rayaanatif/qidi-q2-pen-plotter/hardware/README.md

# Hardware

All files are in `stl/` (print-ready) and `step/` (for editing). Version 4.

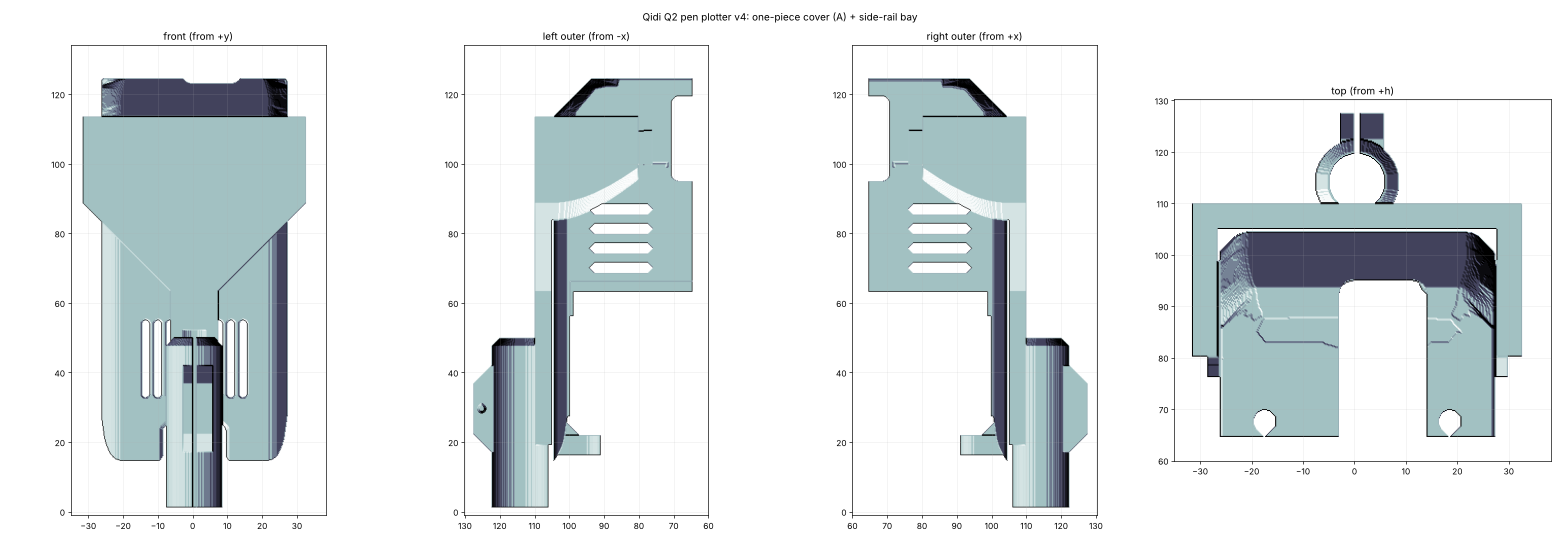
[picture p1: hardware/assembly_views.png]
assembly


| File | Print | Notes |
| --- | --- | --- |
| `qs_cover_v4_A_FRONT_DOWN_print.stl` | Cover, variant A | Front face down, no supports |
| `qs_cover_v4_B_FRONT_DOWN_print.stl` | Cover, variant B | Front face down, no supports |
| `qs_cover_v5_A_dovetail_looser_2.20_top-1.8_blockstop_gap0.15/0.40_FRONT_DOWN_print.stl` | Cover with block stop | The looser-dovetail A cover plus a 9 mm wide rib on the left lug, against the inside of the front wall, rising through the open window to a 2 mm thick hook tongue (6.4 mm deep) that sits just under the black block above the PCB. If cutting force lifts the cover, the tongue meets the block, so the cover rises only the gap (0.15 mm, or 0.40 mm if the tight one won't seat). **The tongue top is at 45.85 / 45.6 mm above the cover's bottom edge, assuming the block underside is 46.0 mm up (30 mm above the duct magnets). Measure yours with calipers before printing.** The rib is 1.4 mm thick in a ~2 mm gap in front of the PCB, so check clearance on first fit. STEP files (`..._blockstop_..._model_orientation.step`) are in `step/`. |
| `qs_pen_bay_v4_print.stl` | Pen bay | Already flipped, flat crossbar on the bed |
| `qs_pen_cartridge_v4_bore7.0.stl` to `bore11.5.stl` | Pen cartridge | Print upright. One file per pen size, in 0.5 mm steps from 7.0 to 11.5 mm. Pick the bore about 0.1 to 0.2 mm bigger than your pen's barrel. All of them have the same outside, so they fit the same bay, clip and jig. Walls get thin above 10.5 mm, so print those slowly at 100% infill |
| `qs_pen_height_jig_v1_tip3.2/4.2/5.2.stl` | Pen height jig | Sets how far the pen tip sticks out below the cartridge collar, so you don't need `PEN_TOUCH` after every pen change. Pick the number that matches your tip height (4.2 mm is what I use) |
| `qs_bay_wedge_clip_v1_end7.7/7.9/8.1.stl` | Screwless clamp | A wedge clip that slides onto the bay's two clamp ears and squeezes them shut instead of the M2 screw. See below |
| `qs_cutter_sleeve_v1_bore10.5/11.0/11.5.stl` | Cutter sleeve | Experimental, see [../docs/CUTTER.md](../docs/CUTTER.md) |

Print one cover, variant A or B (TODO: describe the difference between them).

STEP files: the cover, in print orientation and in model orientation.

## You will also need

- M2x8 screw, one (bay clamp). M2x6, M2x8 and M2x20 are the only sizes I used.
- 4 magnets, 5 x 2 mm.
- CA glue.

## Assembly

1. Fit the cover on the toolhead. For the magnets: stick each 5 x 2 mm magnet onto the duct-wing magnet (right polarity), lower the cover over them, then drip CA glue into the slot.
2. Slide the bay onto the two side rails from the **front**, toward the back, until the crossbar touches the cover face. The fit is tapered, so it is snug at the end.
3. Drop the cartridge with the pen in from the top and nip the M2x8 clamp screw.

The bay bore is 12.8 mm and the cartridge outside diameter is 12.6 mm, with a slit so the clamp screw can squeeze it onto the pen.

## Pen height jig

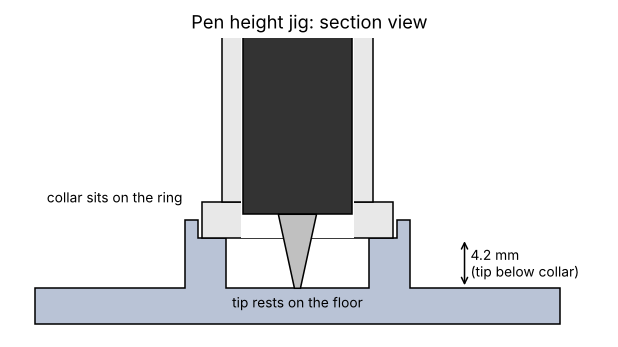
[picture p2: hardware/jig_section.png]
jig


1. Put the jig on a flat table, ring side up.
2. With the bay screw loose, stand the bay and cartridge on the jig so the cartridge collar sits on the ring.
3. Drop the pen in from the top until the tip rests on the floor.
4. Tighten the M2x8 clamp screw. The tip now sticks out exactly the same amount every time.

The three files differ only in how far the tip sticks out below the collar: 3.2, 4.2 or 5.2 mm. Use the same one every time, and keep the `z_draw` you found with it.

## Screwless wedge clip

The 7.9 version has been tested on a real Q2 and holds the cartridge well. The 7.7 and 8.1 versions are untested spares for printers that run a little tight or loose.

The bay's clamp ears are 8.8 mm thick with the slit open and 8.0 mm with it closed. The clip is a U with a tapered inside: it is 9.1 mm wide at the mouth, narrowing to 7.7, 7.9 or 8.1 mm (the number in the file name) at the bridge.

1. Set the cartridge height with the jig and leave the M2 screw out.
2. Slide the clip onto the ears from the top, bridge end first, with the thumb tab facing out, and push it until it stops.
3. The taper squeezes the slit shut. The slope is shallow enough (about 6 degrees on each side) that friction keeps it locked.

Print it upright (the U standing on its mouth) in PETG or ABS, 100% infill, 4 perimeters. Try the 7.9 first. If it will not go on, use 8.1. If it goes on but is loose, use 7.7.

## Looser dovetail cover (shorter top)

The original cover A has a very snug dovetail: it slides on but is hard to remove. These STEP files thin the cover's dovetail rails and lower the roof by 1.8 mm. The pen bay is unchanged. The roof pin holes have a flat-tipped teardrop so the roof edge stays closed above them (0.6 mm wall).

- `qs_cover_v4_A_dovetail_looser_2.20_top-1.8_FRONT_DOWN_print.step`: slightly looser (rails about 0.1 mm thinner on each flank). Try this first.
- `qs_cover_v4_A_dovetail_looser_2.10_top-1.8_FRONT_DOWN_print.step`: looser again (about 0.2 mm).
- `_model_orientation` copies of both are in the same folder.

Printed front-down, nothing overhangs more than 45.3 degrees and there are no flat downward faces above the bed.

## Stiffer, support-free pen bay (v6)

The v4 bay flexes along the short length of spine between the bracket and the pen tube. v6 adds two side wings along that section, outside the pen and collar footprint, so it still slides on and off the same way. The dovetail grooves are unchanged from v4 (0.22 mm clearance); the extra slide clearance comes from the thinner rails on the looser cover above.

The top end of the pen barrel is now a single 45 degree ramp merged into the spine instead of a floating ring, so the bay prints bracket-down with no supports. The barrel's top no longer has a flat rim, so the pen cartridge has to seat from the bottom end.

- `qs_pen_bay_v6_ramp_flanges_comb_print.step`: side wings plus three small tines that slide into the middle front vents of the cover to lock the bay sideways. Cut the tines off if they bind.
- `qs_pen_bay_v6_ramp_flanges_print.step`: side wings only.
- `_model_orientation` copies of both are in the same folder.

Printed bracket-down, nothing overhangs more than 45 degrees (the M2 teardrop holes point their tip up). The round parts (tube and bore) are 72-sided polygons in the STEP.

## Pen cartridges as STEP

`hardware/step/qs_pen_cartridge_v4_bore9.0.step` and `..._bore10.0.step` are clean STEP versions of the 9.0 and 10.0 mm cartridges. Print them collar-up (the collar cone and the funnel are 45 degrees, so no supports). The round faces are 72-sided polygons. Other bore sizes are available as STL.
