rayaanatif/qidi-q2-pen-plotter/hardware/plate-280-tiles/README.txt

Q2 280 mm plate replica - 4 printed tiles with alignment rings (dual colour)
Tiles: LF (front-left), LR (rear-left), RF (front-right, front handle), RR (rear-right, rear tab). Files per tile: *_base.stl (print in a light coloured filament so white paper stands out, e.g. yellow, light blue or light green - not dark), *_black.stl (12 rings in total across the tiles  black), *_combined.stl / .step (both). In the slicer import base+black as one multi-part object, or use the combined STL and change colour at z = 3.0 mm (pause or Box).
Each tile prints flat, pockets down, 3 mm base + 0.4 mm rings . Largest tile 201 x 152 mm.
Dovetail keys lock the seams (0.15 mm clearance); add a drop of CA glue or epoxy. Magnets: 4 pockets per tile (16 total), 5 x 2 mm, same pole up.
Alignment: assemble, place on the bed like the original plate (rear-left corner of the 280 plate). In the app tick "Using alignment reference sheet": the rings are at exactly the same positions as the printed sheet (hardware/registration-plate). There is no paper stop: put paper or other material anywhere inside the rings, in any orientation.
Outline ESTIMATED from a product photo: rear tab 35 x 12, front handle 118 > 98 x 10.5. Edit the constants at the top of plate_tiles.py after measuring.
Thickness 3 mm is more than the original flex plate; re-measure z_draw with PEN_TOUCH.
