rayaanatif/qidi-q2-pen-plotter/hardware/registration-plate/README.txt

Printable alignment reference sheets for the Q2 (280 mm plate). Print at 100% (Actual size).
q2_regsheet_A3.pdf - one A3 page. q2_regsheet_2xA4_landscape.pdf - two A4 pages, cut page 2 along the dashed line and match the numbered ruler to page 1.
12 rings: 4 corners plus the left, rear and right strips, clear of an A4 sheet pushed into the rear-left corner. Corner of the sheet goes on the plate's rear-left corner.
A printable plate to glue it onto: ../plate-280-tiles
