rayaanatif/qidi-q2-pen-plotter/hardware/plate-280-tiles/q2_plate280_tiles_preview.png

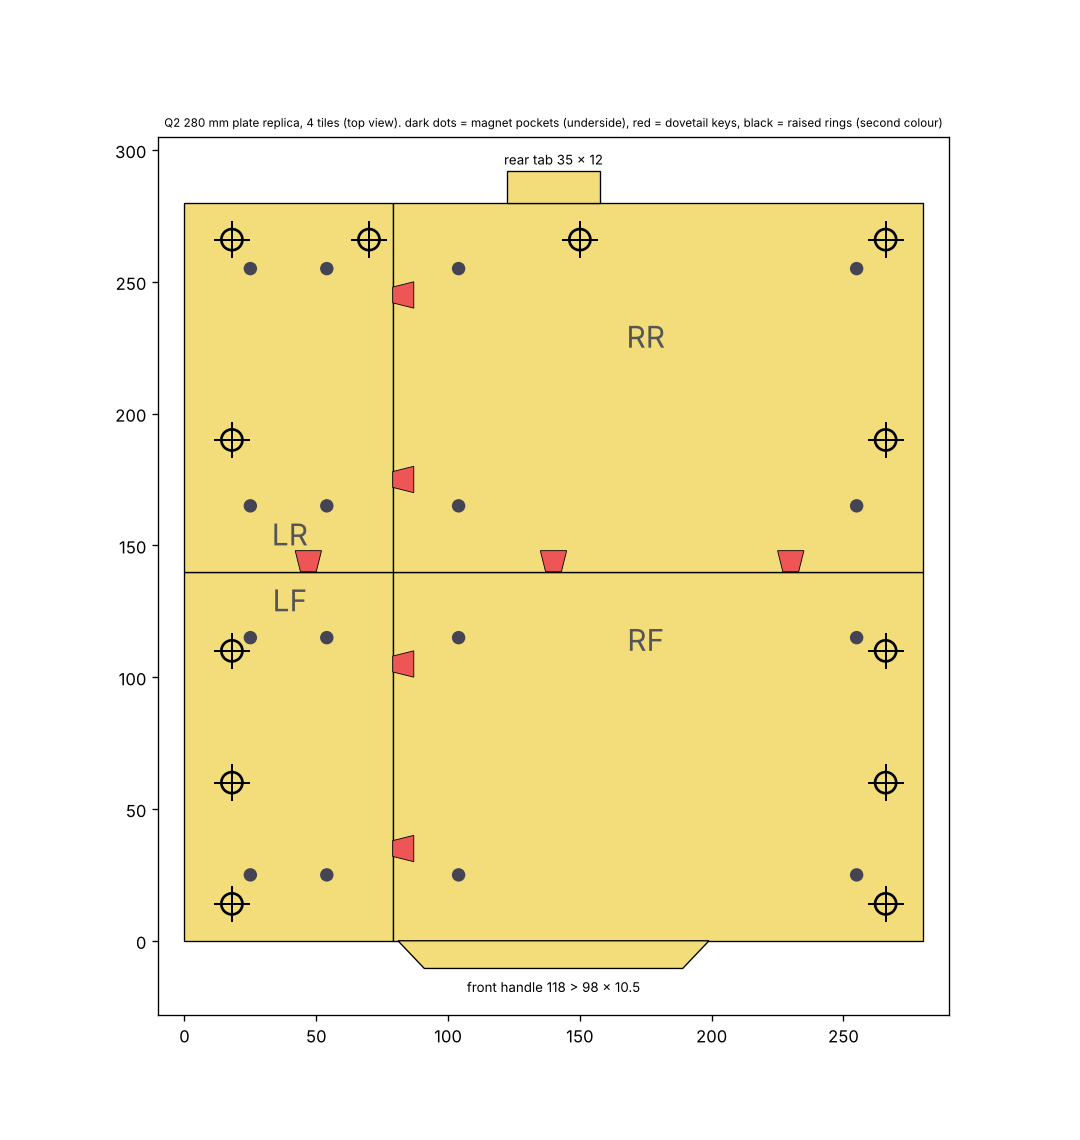
hardware/plate-280-tiles/q2_plate280_tiles_preview.png
