rayaanatif/qidi-q2-pen-plotter/hardware/cutter-gcc/qs_cutter_pusher_v2_hard.stl

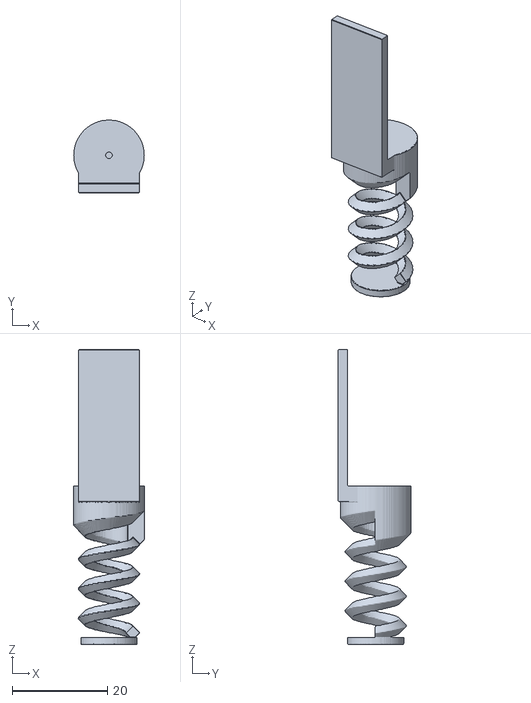
[picture p6: CAD file, 2026-11-13]
hardware/cutter-gcc/qs_cutter_pusher_v2_hard.stl
14.8 x 15.3 x 61.9
