rayaanatif/qidi-q2-pen-plotter/hardware/cutter-gcc/v3_step/qs_cutter_adj_plunger_v3_print.step

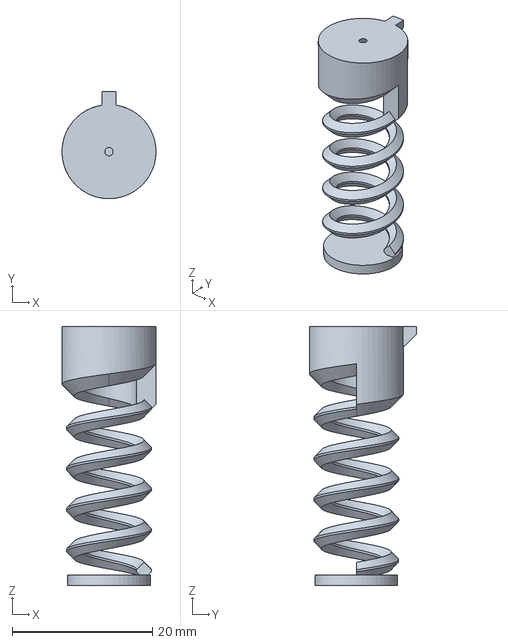
[picture p7: CAD file, 2026-11-13]
hardware/cutter-gcc/v3_step/qs_cutter_adj_plunger_v3_print.step
13.4 x 15.3 x 36.9 mm
