rayaanatif/qidi-q2-pen-plotter/hardware/step/qs_cover_v5_A_dovetail_looser_2.20_top-1.8_blockstop_gap0.15_model_orientation.step

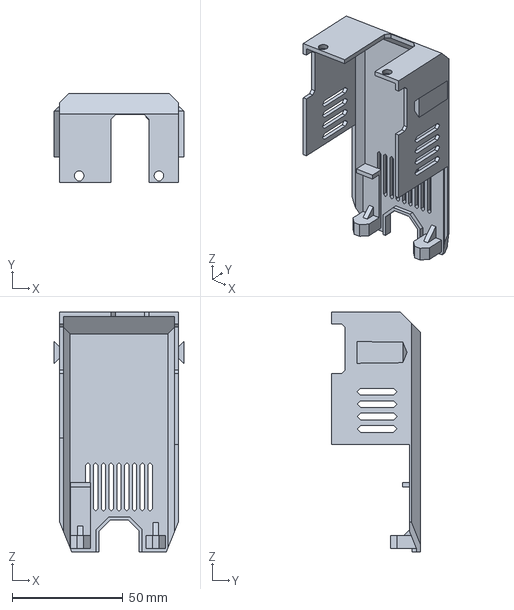
[picture p9: CAD file, 2026-11-13]
hardware/step/qs_cover_v5_A_dovetail_looser_2.20_top-1.8_blockstop_gap0.15_model_orientation.step
58.4 x 40.0 x 108.2 mm
