rayaanatif/qidi-q2-pen-plotter/hardware/stl/qs_pen_cartridge_v4_bore8.5.stl

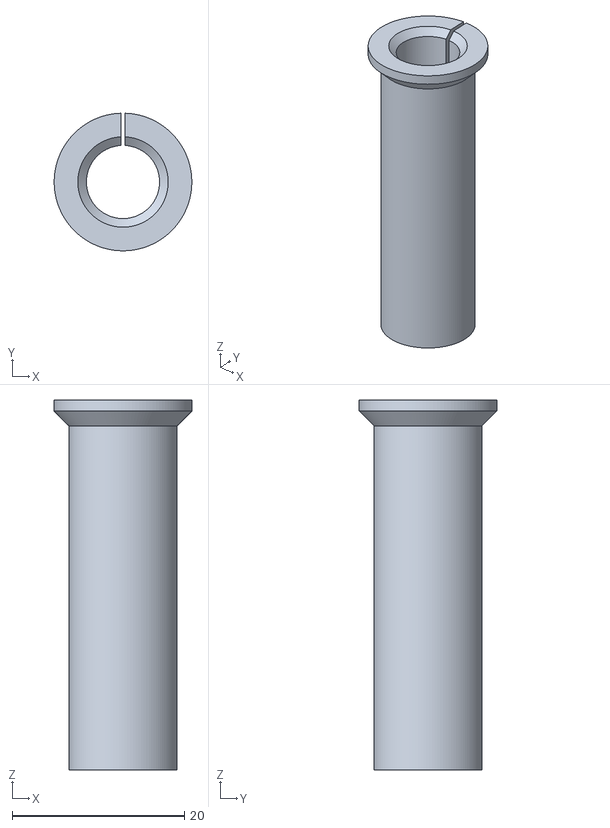
[picture p10: CAD file, 2026-11-07]
hardware/stl/qs_pen_cartridge_v4_bore8.5.stl
16.0 x 16.0 x 43.0
