rayaanatif/qidi-q2-pen-plotter/hardware/cutter-float/qs_cutter_float_v1_3turn_bore11.3.stl

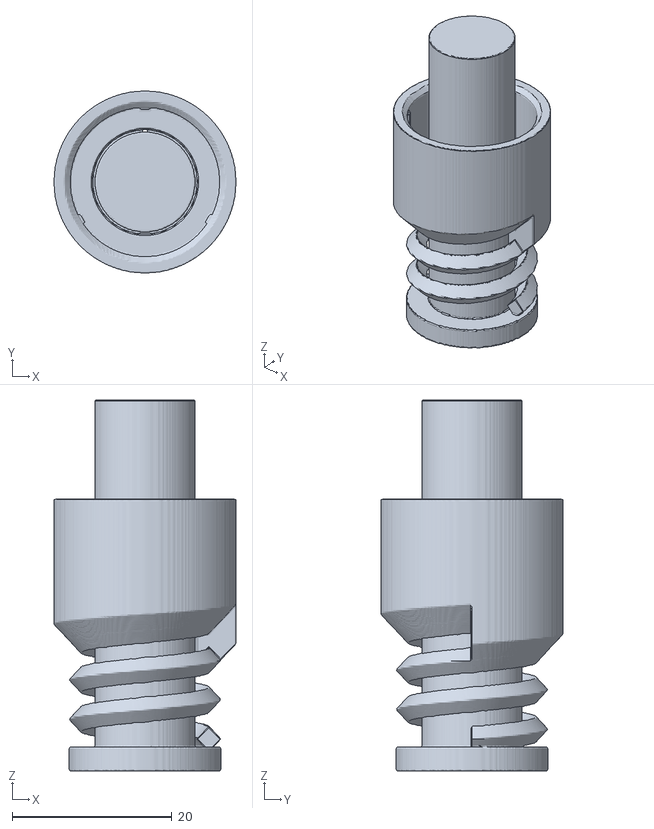
[picture p11: CAD file, 2026-11-13]
hardware/cutter-float/qs_cutter_float_v1_3turn_bore11.3.stl
22.8 x 22.8 x 46.5
