rayaanatif/qidi-q2-pen-plotter/hardware/cutter-gcc/qs_cutter_key_v2.stl

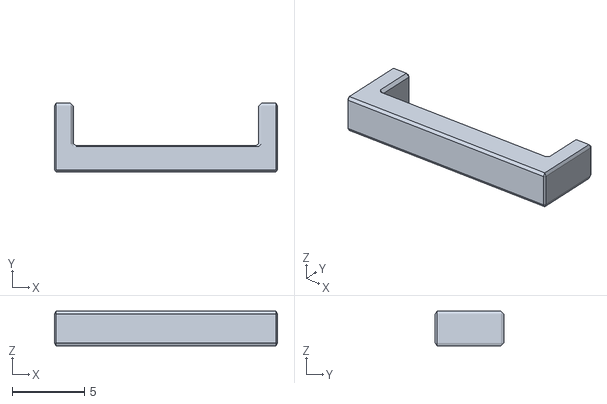
[picture p12: CAD file, 2026-11-13]
hardware/cutter-gcc/qs_cutter_key_v2.stl
15.4 x 4.73 x 2.40
