rayaanatif/qidi-q2-pen-plotter/hardware/cutter-gcc/v3_step/qs_cutter_adj_frame_v3_print.step

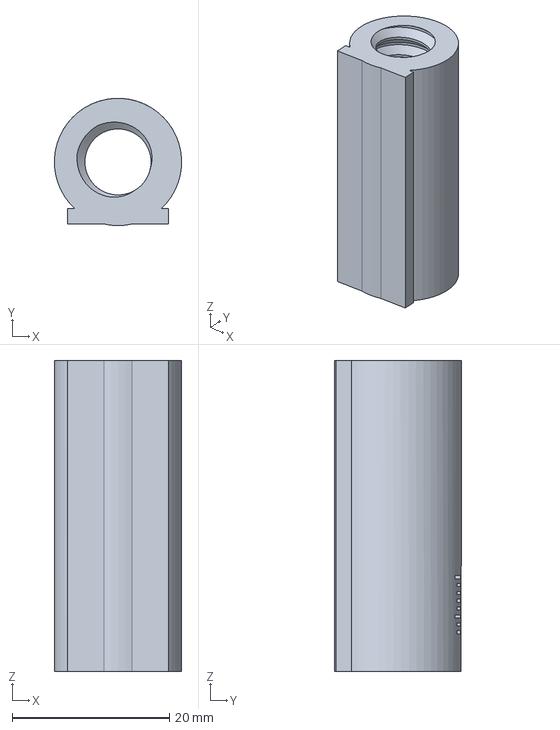
[picture p13: CAD file, 2026-11-13]
hardware/cutter-gcc/v3_step/qs_cutter_adj_frame_v3_print.step
16.2 x 16.2 x 39.6 mm
