rayaanatif/qidi-q2-pen-plotter/hardware/cutter-gcc/qs_cutter_pusher_v2_soft.stl

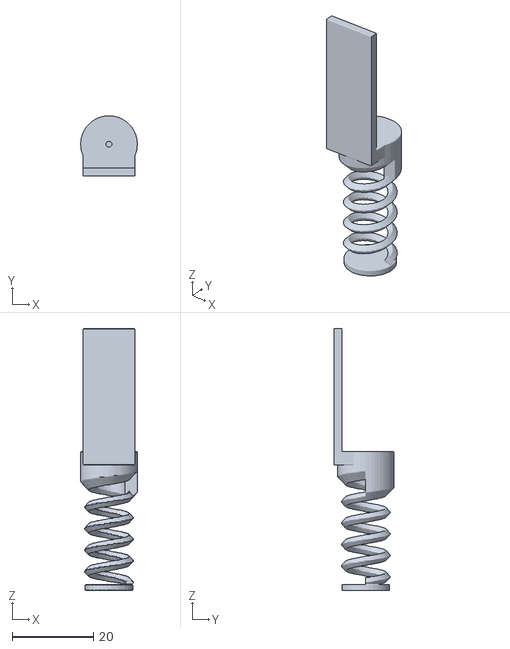
[picture p14: CAD file, 2026-11-13]
hardware/cutter-gcc/qs_cutter_pusher_v2_soft.stl
14.0 x 14.9 x 64.6
