rayaanatif/qidi-q2-pen-plotter/hardware/cutter-gcc/v3_step/qs_cutter_pusher_v3_firm_model_orientation.step

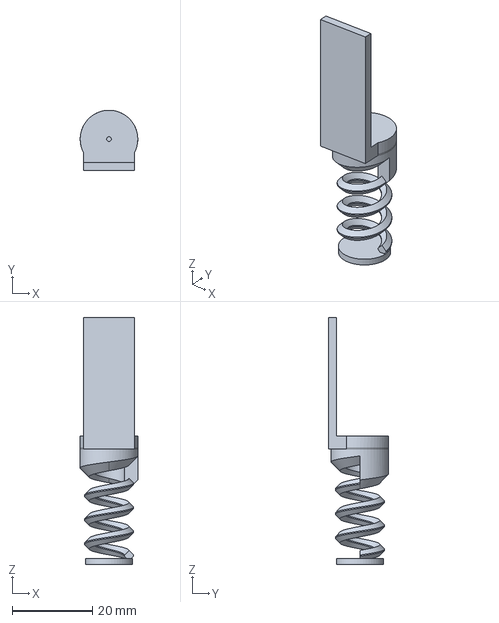
[picture p15: CAD file, 2026-11-13]
hardware/cutter-gcc/v3_step/qs_cutter_pusher_v3_firm_model_orientation.step
14.4 x 15.1 x 61.7 mm
