rayaanatif/qidi-q2-pen-plotter/hardware/plate-280-tiles/q2_plate280_tile_LR_black.stl

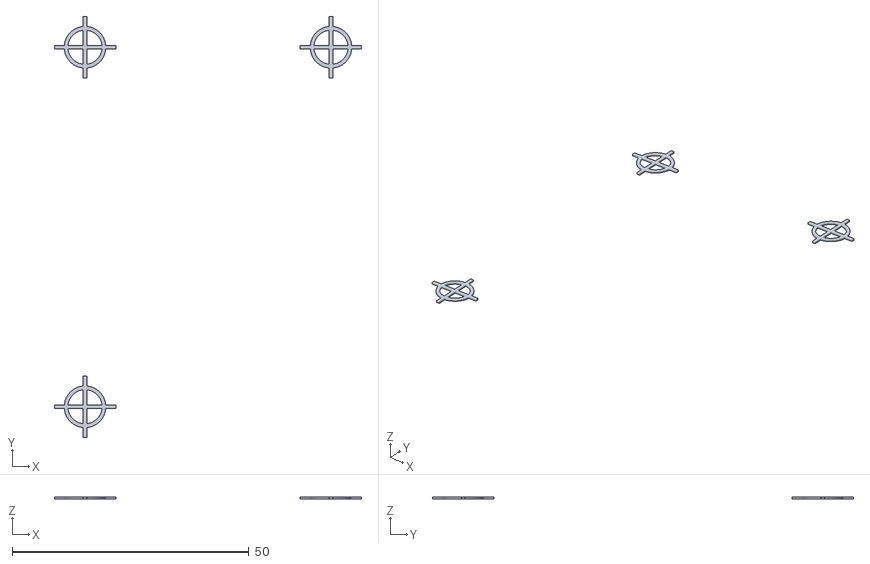
[picture p16: CAD file, 2026-11-09]
hardware/plate-280-tiles/q2_plate280_tile_LR_black.stl
65.0 x 89.0 x 0.42
