rayaanatif/qidi-q2-pen-plotter/hardware/cutter-gcc/qs_cutter_adj_rod_knob_v2.stl

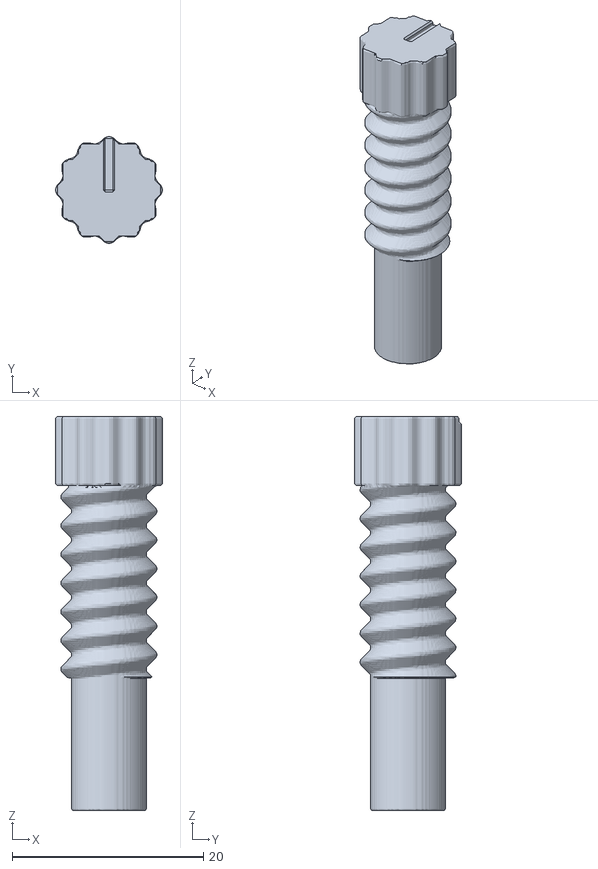
[picture p18: CAD file, 2026-11-13]
hardware/cutter-gcc/qs_cutter_adj_rod_knob_v2.stl
11.2 x 11.2 x 41.2
