rayaanatif/qidi-q2-pen-plotter/hardware/cutter-gcc/v3_step/qs_cutter_key_v3_print.step

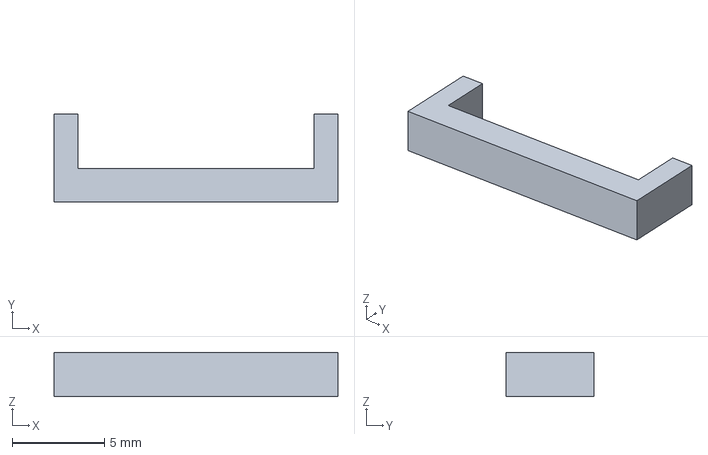
[picture p19: CAD file, 2026-11-13]
hardware/cutter-gcc/v3_step/qs_cutter_key_v3_print.step
15.4 x 4.75 x 2.40 mm
