rayaanatif/qidi-q2-pen-plotter/hardware/plate-280-tiles/q2_plate280_tile_LF_base.stl

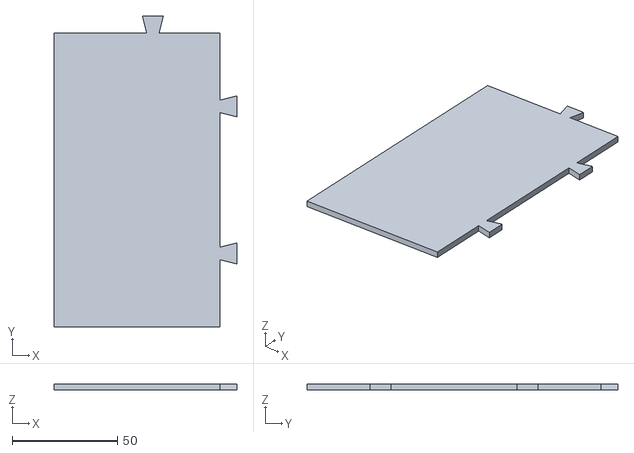
[picture p20: CAD file, 2026-11-09]
hardware/plate-280-tiles/q2_plate280_tile_LF_base.stl
87.0 x 148.0 x 3.00
