rayaanatif/qidi-q2-pen-plotter/hardware/cutter-gcc/v3_step/qs_cutter_pusher_v3_std_model_orientation.step

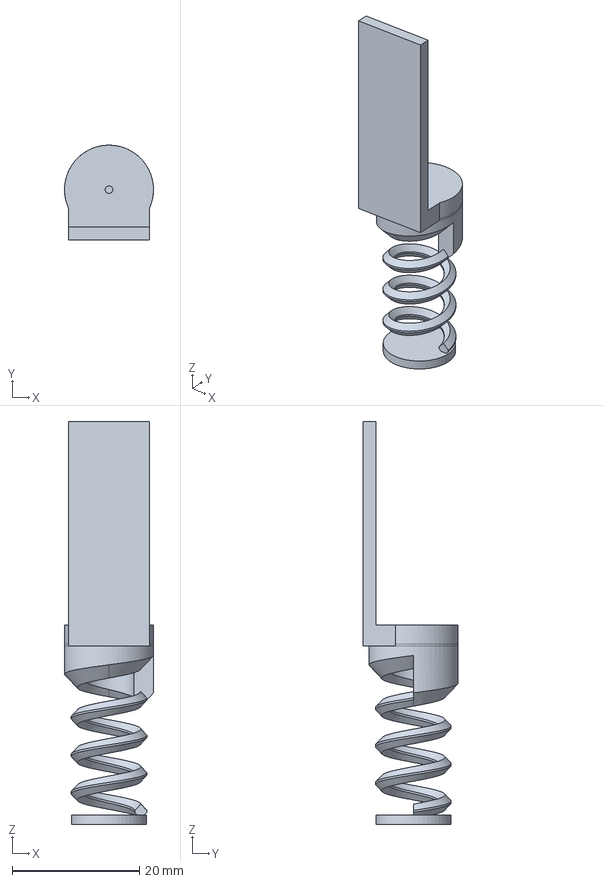
[picture p21: CAD file, 2026-11-13]
hardware/cutter-gcc/v3_step/qs_cutter_pusher_v3_std_model_orientation.step
14.0 x 14.9 x 63.4 mm
