rayaanatif/qidi-q2-pen-plotter/hardware/step/qs_pen_cartridge_v4_bore9.0.step

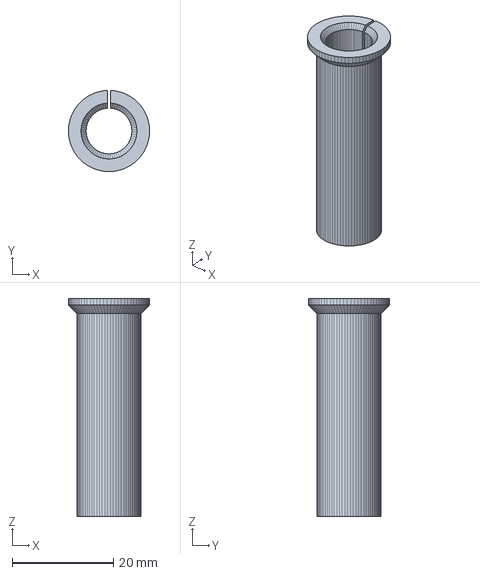
[picture p23: CAD file, 2026-11-09]
hardware/step/qs_pen_cartridge_v4_bore9.0.step
16.0 x 16.0 x 43.0 mm
