rayaanatif/qidi-q2-pen-plotter/hardware/stl/qs_bay_wedge_clip_v1_end7.7.stl

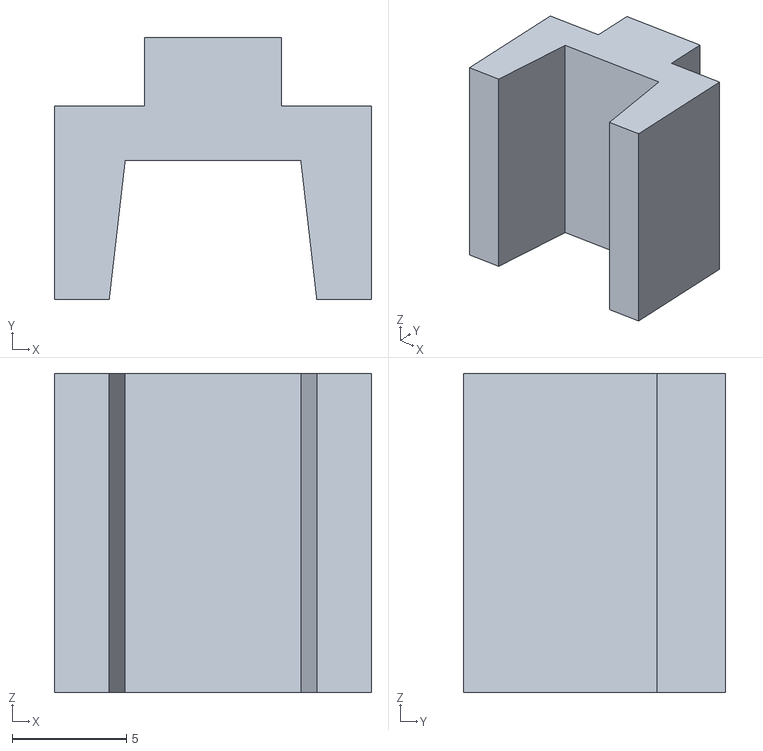
[picture p24: CAD file, 2026-11-07]
hardware/stl/qs_bay_wedge_clip_v1_end7.7.stl
13.9 x 11.5 x 14.0
