rayaanatif/qidi-q2-pen-plotter/hardware/cutter-gcc/qs_cutter_adj_frame_v2.stl

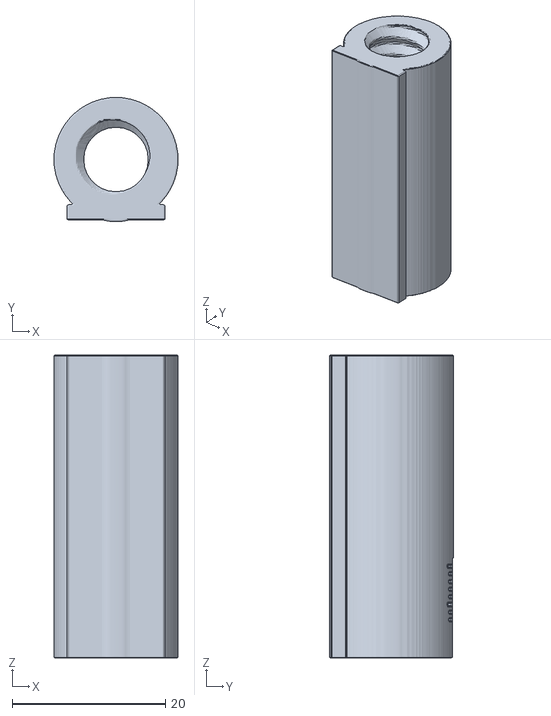
[picture p25: CAD file, 2026-11-13]
hardware/cutter-gcc/qs_cutter_adj_frame_v2.stl
16.2 x 16.2 x 39.6
