rayaanatif/qidi-q2-pen-plotter/hardware/cutter-gcc/v3_step/qs_cutter_pusher_v3_soft_print.step

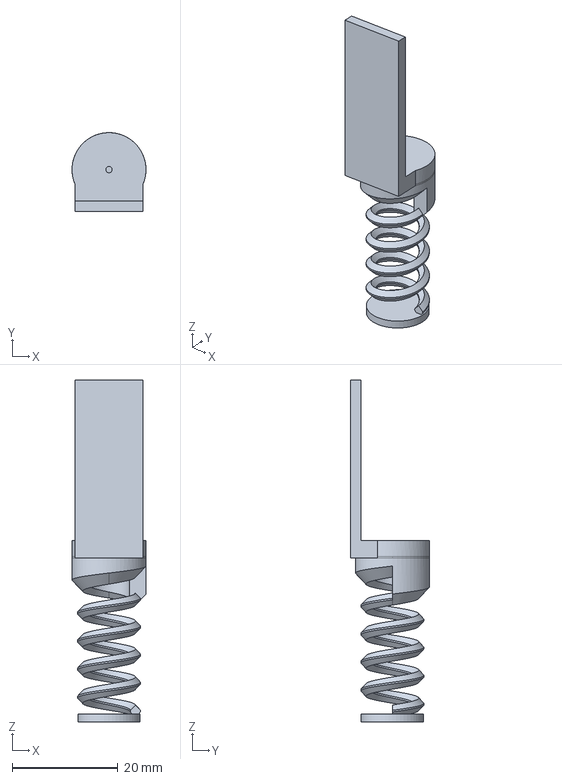
[picture p26: CAD file, 2026-11-13]
hardware/cutter-gcc/v3_step/qs_cutter_pusher_v3_soft_print.step
14.0 x 14.9 x 64.7 mm
