rayaanatif/qidi-q2-pen-plotter/hardware/plate-280-tiles/q2_plate280_tile_RR_black.stl

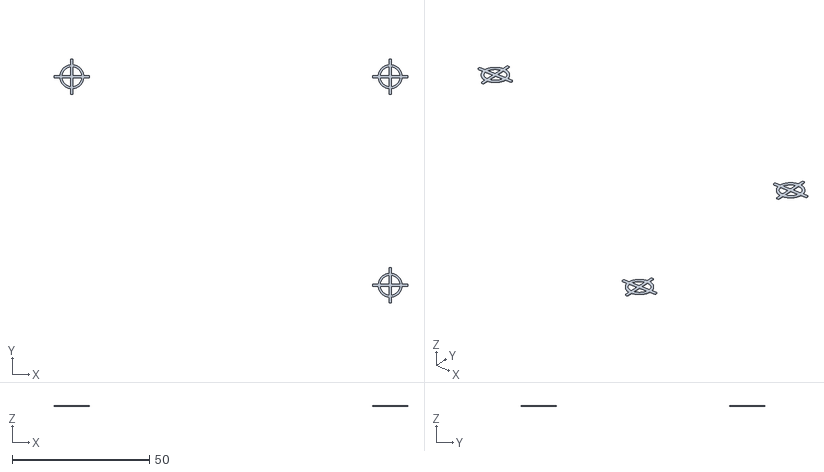
[picture p27: CAD file, 2026-11-09]
hardware/plate-280-tiles/q2_plate280_tile_RR_black.stl
129.0 x 89.0 x 0.42
