rayaanatif/qidi-q2-pen-plotter/hardware/plate-280-tiles/q2_plate280_tile_RF_black.stl

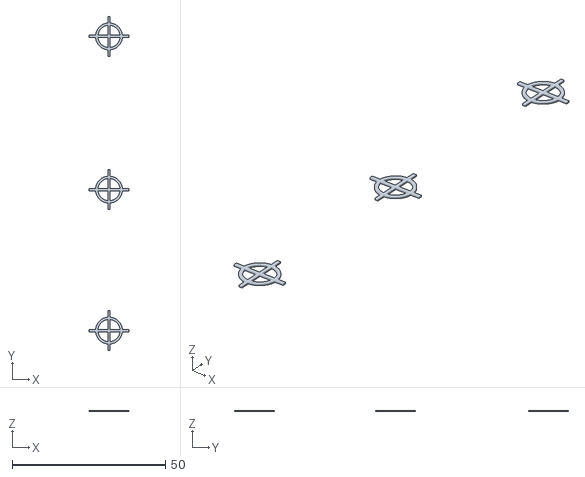
[picture p28: CAD file, 2026-11-09]
hardware/plate-280-tiles/q2_plate280_tile_RF_black.stl
13.0 x 109.0 x 0.42
