rayaanatif/qidi-q2-pen-plotter/hardware/step/qs_pen_bay_v6_ramp_flanges_comb_model_orientation.step

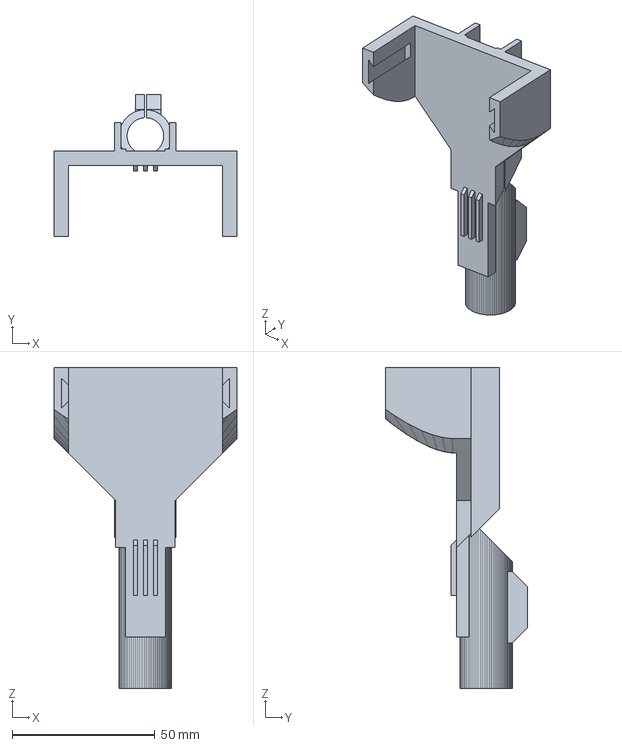
[picture p29: CAD file, 2026-11-07]
hardware/step/qs_pen_bay_v6_ramp_flanges_comb_model_orientation.step
64.1 x 49.7 x 112.5 mm
