rayaanatif/qidi-q2-pen-plotter/hardware/plate-280-tiles/q2_plate280_tile_RR_base.stl

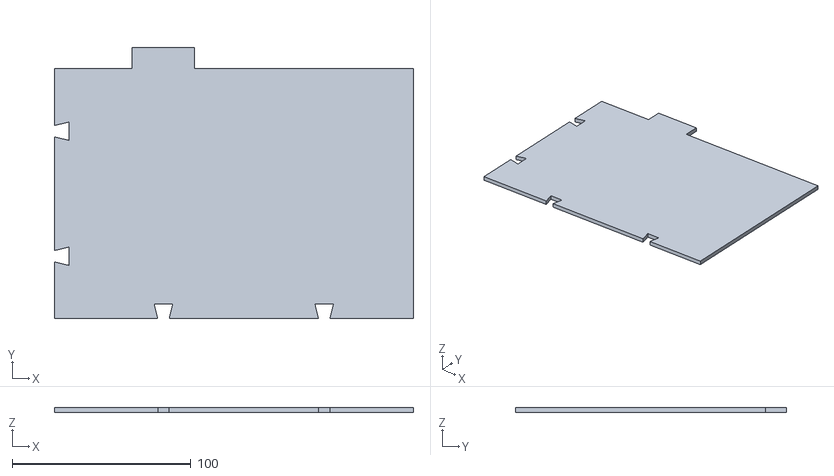
[picture p30: CAD file, 2026-11-09]
hardware/plate-280-tiles/q2_plate280_tile_RR_base.stl
201.0 x 152.0 x 3.00
