rayaanatif/qidi-q2-pen-plotter/hardware/stl/qs_pen_height_jig_v1_tip5.2.stl

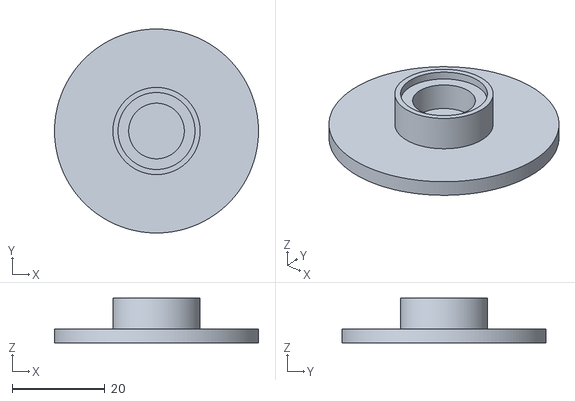
[picture p31: CAD file, 2026-11-07]
hardware/stl/qs_pen_height_jig_v1_tip5.2.stl
44.0 x 44.0 x 9.70
