rayaanatif/qidi-q2-pen-plotter/hardware/plate-280-tiles/q2_plate280_tile_RF_base.stl

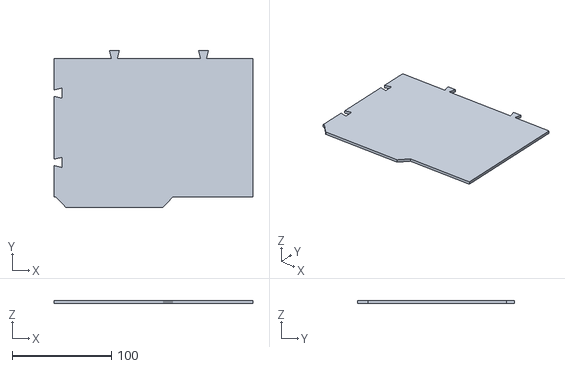
[picture p32: CAD file, 2026-11-09]
hardware/plate-280-tiles/q2_plate280_tile_RF_base.stl
201.0 x 158.5 x 3.00
