rayaanatif/qidi-q2-pen-plotter/hardware/stl/qs_pen_height_jig_v1_tip3.2.stl

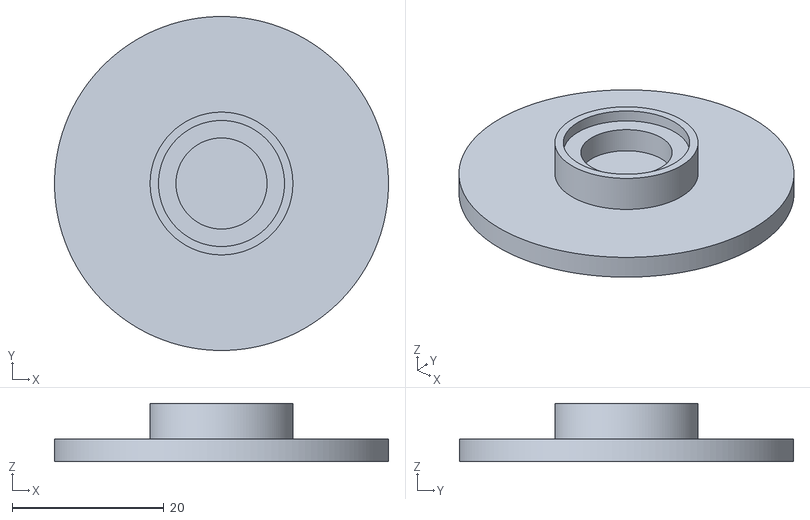
[picture p33: CAD file, 2026-11-07]
hardware/stl/qs_pen_height_jig_v1_tip3.2.stl
44.0 x 44.0 x 7.70
