rayaanatif/qidi-q2-pen-plotter/hardware/plate-280-tiles/q2_plate280_tile_RR.step

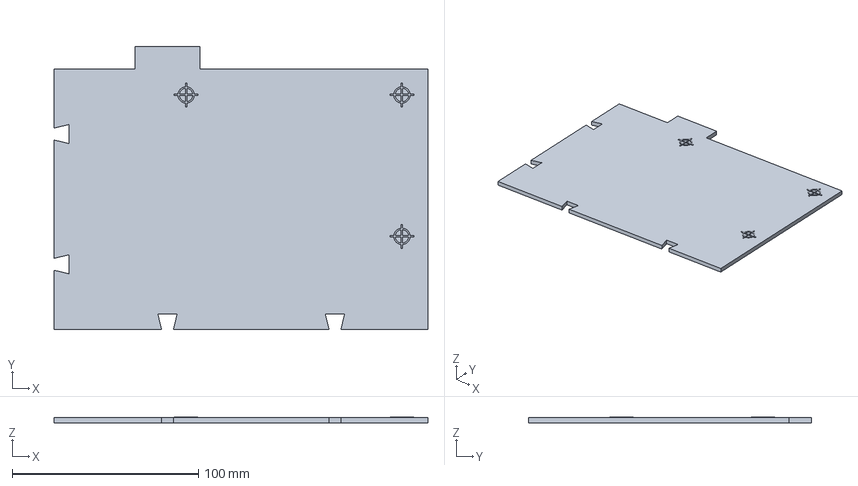
[picture p34: CAD file, 2026-11-09]
hardware/plate-280-tiles/q2_plate280_tile_RR.step
201.0 x 152.0 x 3.40 mm
