rayaanatif/qidi-q2-pen-plotter/hardware/stl/qs_pen_height_jig_v1_tip4.2.stl

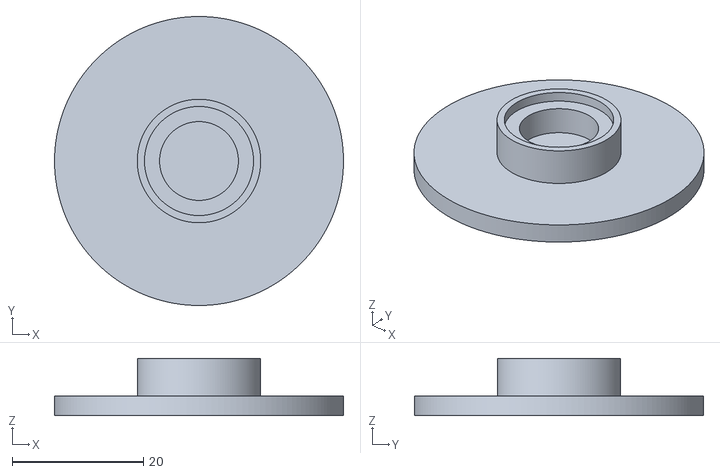
[picture p35: CAD file, 2026-11-07]
hardware/stl/qs_pen_height_jig_v1_tip4.2.stl
44.0 x 44.0 x 8.70
