rayaanatif/qidi-q2-pen-plotter/hardware/step/qs_cover_v4_A_dovetail_looser_2.10_top-1.8_FRONT_DOWN_print.step

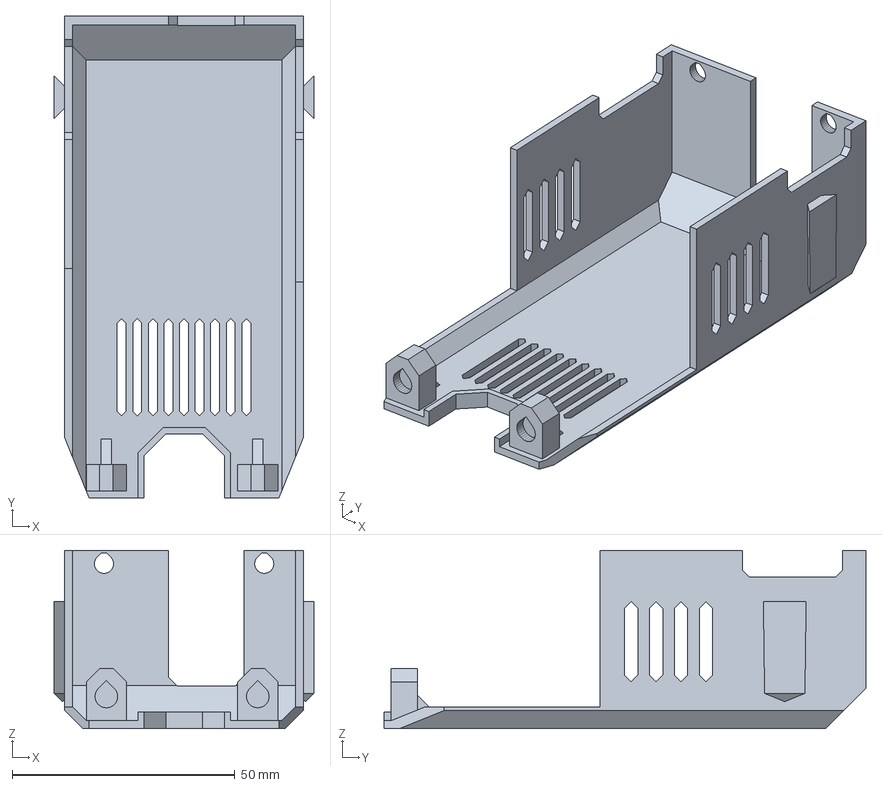
[picture p37: CAD file, 2026-11-07]
hardware/step/qs_cover_v4_A_dovetail_looser_2.10_top-1.8_FRONT_DOWN_print.step
58.4 x 108.2 x 40.0 mm
