rayaanatif/qidi-q2-pen-plotter/hardware/stl/qs_pen_cartridge_v4_bore10.5.stl

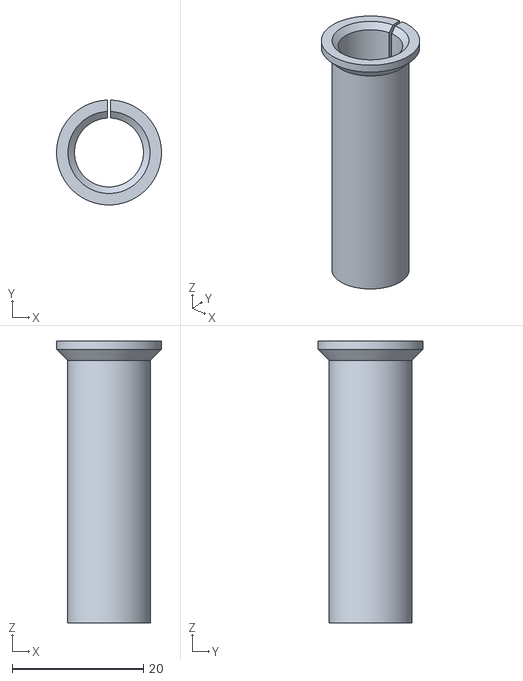
[picture p38: CAD file, 2026-11-06]
hardware/stl/qs_pen_cartridge_v4_bore10.5.stl
16.0 x 16.0 x 43.0
