rayaanatif/qidi-q2-pen-plotter/hardware/stl/qs_pen_bay_v4_print.stl

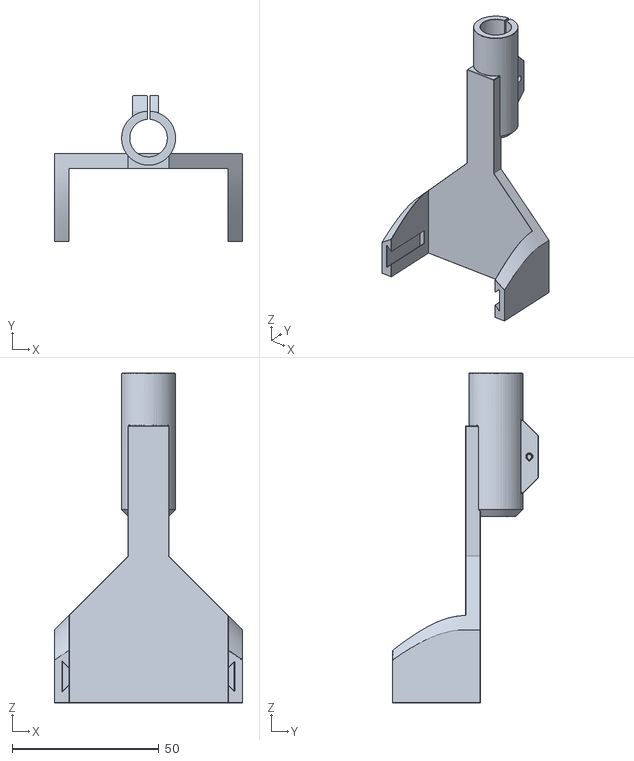
[picture p39: CAD file, 2026-11-06]
hardware/stl/qs_pen_bay_v4_print.stl
64.1 x 49.7 x 112.5
