rayaanatif/qidi-q2-pen-plotter/hardware/plate-280-tiles/q2_plate280_tile_LR_base.stl

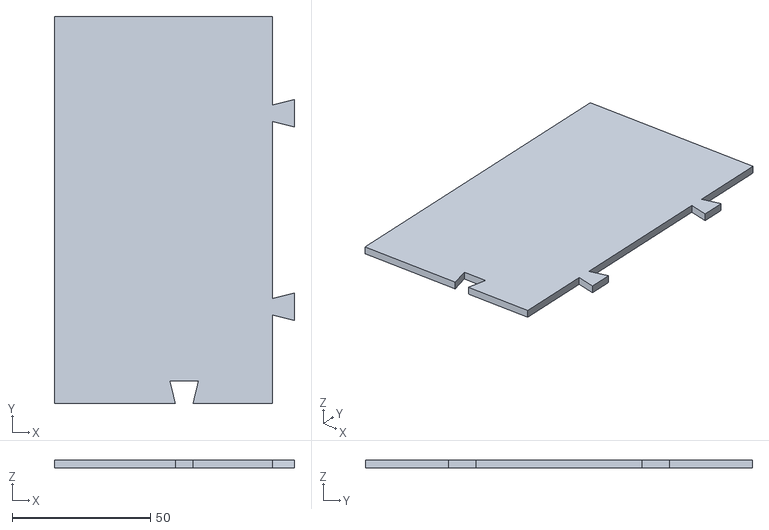
[picture p40: CAD file, 2026-11-09]
hardware/plate-280-tiles/q2_plate280_tile_LR_base.stl
87.0 x 140.0 x 3.00
