rayaanatif/qidi-q2-pen-plotter/hardware/cutter-gcc/v3_step/qs_cutter_bay_v3_print.step

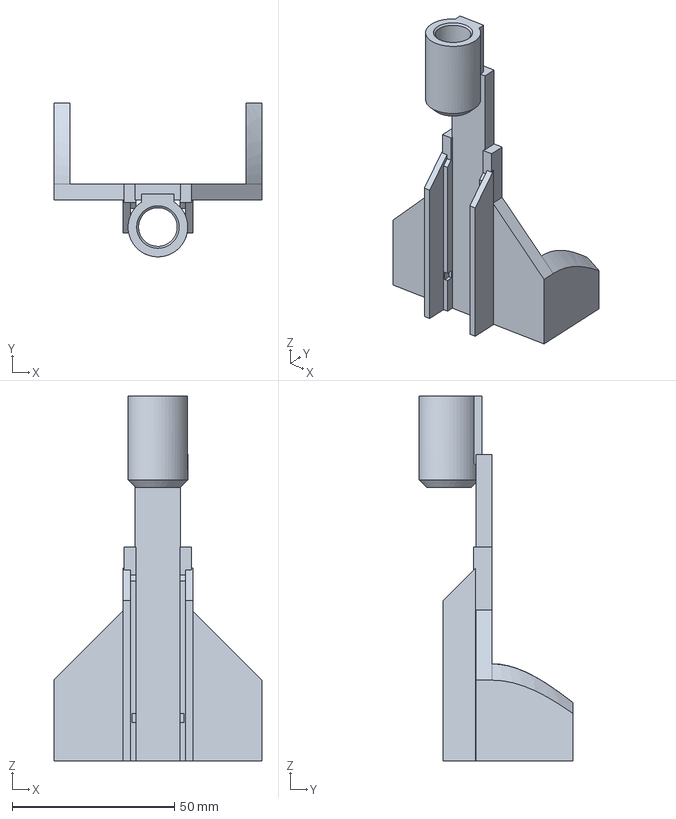
[picture p41: CAD file, 2026-11-13]
hardware/cutter-gcc/v3_step/qs_cutter_bay_v3_print.step
64.1 x 47.4 x 112.5 mm
