rayaanatif/qidi-q2-pen-plotter/(list of files, cad)

Other CAD files:
hardware/plate-280-tiles/q2_plate280_tile_LR.step
hardware/step/qs_cover_v5_A_dovetail_looser_2.20_top-1.8_blockstop_gap0.15_FRONT_DOWN_print.step
hardware/stl/qs_pen_cartridge_v4_bore8.0.stl
hardware/step/qs_cover_v5_A_dovetail_looser_2.20_top-1.8_blockstop_gap0.40_model_orientation.step
hardware/step/qs_cover_v5_A_dovetail_looser_2.20_top-1.8_blockstop_gap0.40_FRONT_DOWN_print.step
hardware/stl/qs_pen_cartridge_v4_bore7.5.stl
hardware/cutter-gcc/qs_cutter_pusher_v2_firm.stl
hardware/step/qs_pen_cartridge_v4_bore10.0.step
hardware/stl/qs_bay_wedge_clip_v1_end7.9.stl
hardware/cutter-gcc/qs_cutter_bay_v2.stl
hardware/cutter-gcc/v3_step/qs_cutter_pusher_v3_hard_model_orientation.step
hardware/stl/qs_bay_wedge_clip_v1_end8.1.stl
hardware/cutter-gcc/qs_cutter_adj_plunger_v2.stl
hardware/cutter-gcc/v3_step/qs_cutter_adj_plunger_v3_model_orientation.step
hardware/step/qs_pen_bay_v6_ramp_flanges_model_orientation.step
hardware/cutter-gcc/qs_cutter_pusher_v2_std.stl
hardware/cutter-gcc/v3_step/qs_cutter_pusher_v3_hard_print.step
hardware/step/qs_pen_bay_v6_ramp_flanges_print.step
hardware/cutter-gcc/v3_step/qs_cutter_key_v3_model_orientation.step
hardware/step/qs_pen_bay_v6_ramp_flanges_comb_print.step
hardware/cutter-gcc/v3_step/qs_cutter_adj_rod_knob_v3_model_orientation.step
hardware/cutter-gcc/v3_step/qs_cutter_pusher_v3_soft_model_orientation.step
hardware/plate-280-tiles/q2_plate280_tile_LF.step
hardware/step/qs_cover_v4_A_dovetail_looser_2.10_top-1.8_model_orientation.step
hardware/cutter-gcc/v3_step/qs_cutter_pusher_v3_std_print.step
hardware/step/qs_cover_v4_A_dovetail_looser_2.20_top-1.8_model_orientation.step
hardware/stl/qs_pen_cartridge_v4_bore11.5.stl
hardware/cutter-gcc/v3_step/qs_cutter_adj_frame_v3_model_orientation.step
hardware/plate-280-tiles/q2_plate280_tile_LF_black.stl
hardware/step/qs_cover_v4_A_dovetail_looser_2.20_top-1.8_FRONT_DOWN_print.step
hardware/stl/qs_pen_cartridge_v4_bore11.0.stl
hardware/plate-280-tiles/q2_plate280_tile_RF.step
hardware/step/qs_cover_v4_A_model_orientation.step
hardware/stl/qs_pen_cartridge_v4_bore9.5.stl
hardware/cutter-gcc/v3_step/qs_cutter_bay_v3_model_orientation.step
hardware/plate-280-tiles/q2_plate280_tile_RR_combined.stl
hardware/step/qs_cover_v4_B_FRONT_DOWN_print.step
hardware/cutter-gcc/v3_step/qs_cutter_pusher_v3_firm_print.step
hardware/step/qs_cover_v4_A_FRONT_DOWN_print.step
hardware/cutter-gcc/v3_step/qs_cutter_adj_rod_knob_v3_print.step
hardware/step/qs_cover_v4_B_model_orientation.step
hardware/cutter-gcc/v3_step/print_stl/qs_cutter_adj_frame_v3_print.stl
hardware/cutter-gcc/v3_step/print_stl/qs_cutter_adj_plunger_v3_print.stl
hardware/cutter-gcc/v3_step/print_stl/qs_cutter_adj_rod_knob_v3_print.stl
hardware/cutter-gcc/v3_step/print_stl/qs_cutter_bay_v3_print.stl
hardware/cutter-gcc/v3_step/print_stl/qs_cutter_key_v3_print.stl
hardware/cutter-gcc/v3_step/print_stl/qs_cutter_pusher_v3_firm_print.stl
hardware/cutter-gcc/v3_step/print_stl/qs_cutter_pusher_v3_hard_print.stl
hardware/cutter-gcc/v3_step/print_stl/qs_cutter_pusher_v3_soft_print.stl
hardware/cutter-gcc/v3_step/print_stl/qs_cutter_pusher_v3_std_print.stl
hardware/stl/qs_cover_v4_A_FRONT_DOWN_print.stl
hardware/stl/qs_cover_v4_B_FRONT_DOWN_print.stl
hardware/stl/qs_cover_v5_A_dovetail_looser_2.20_top-1.8_blockstop_gap0.15_FRONT_DOWN_print.stl
hardware/stl/qs_cover_v5_A_dovetail_looser_2.20_top-1.8_blockstop_gap0.40_FRONT_DOWN_print.stl
hardware/stl/qs_pen_cartridge_v4_bore10.0.stl
hardware/stl/qs_pen_cartridge_v4_bore9.0.stl
