rayaanatif/qidi-q2-pen-plotter/hardware/cutter-gcc/v3_step/assembly_section_v3.png

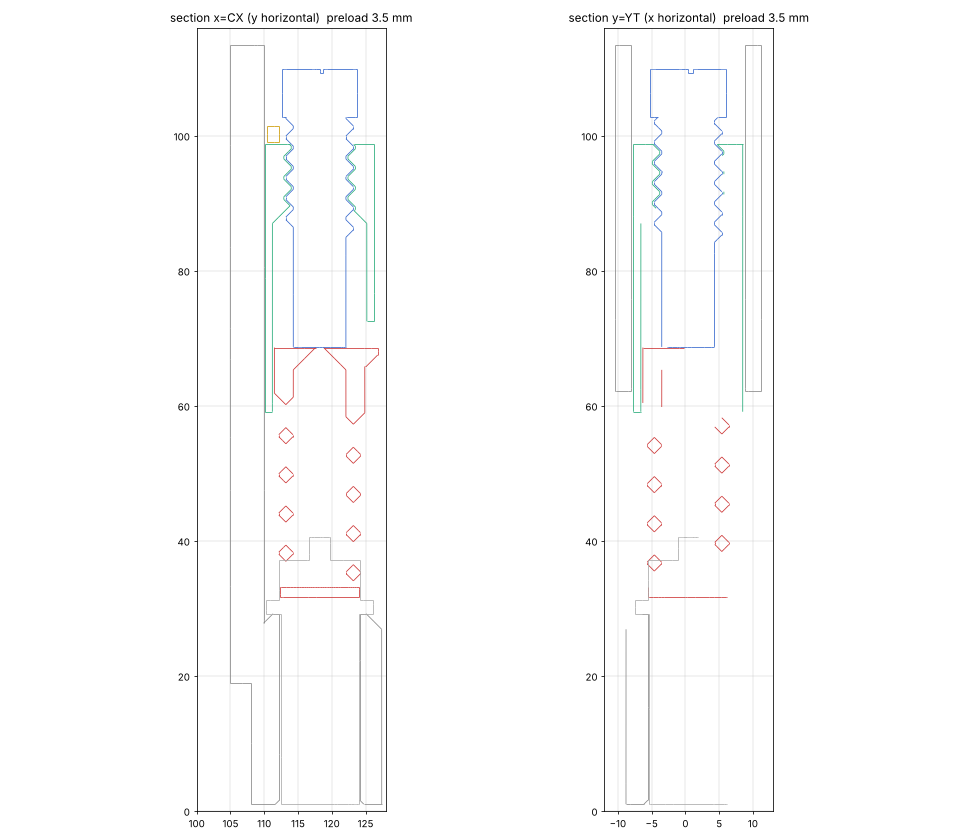
hardware/cutter-gcc/v3_step/assembly_section_v3.png
