rayaanatif/qidi-q2-pen-plotter/hardware/registration-plate/q2_regsheet_2xA4_landscape.pdf

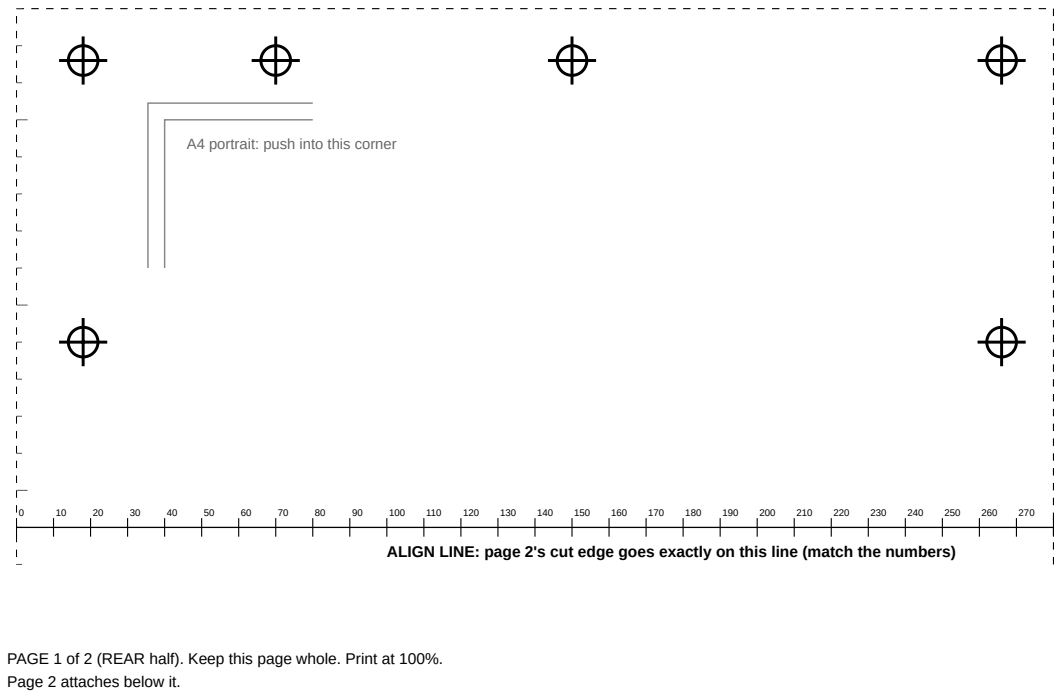
[picture p43: page 1]

A4 portrait: push into this corner

ALIGN LINE: page 2's cut edge goes exactly on this line (match the numbers)

PAGE 1 of 2 (REAR half). Keep this page whole. Print at 100%.
Page 2 attaches below it.

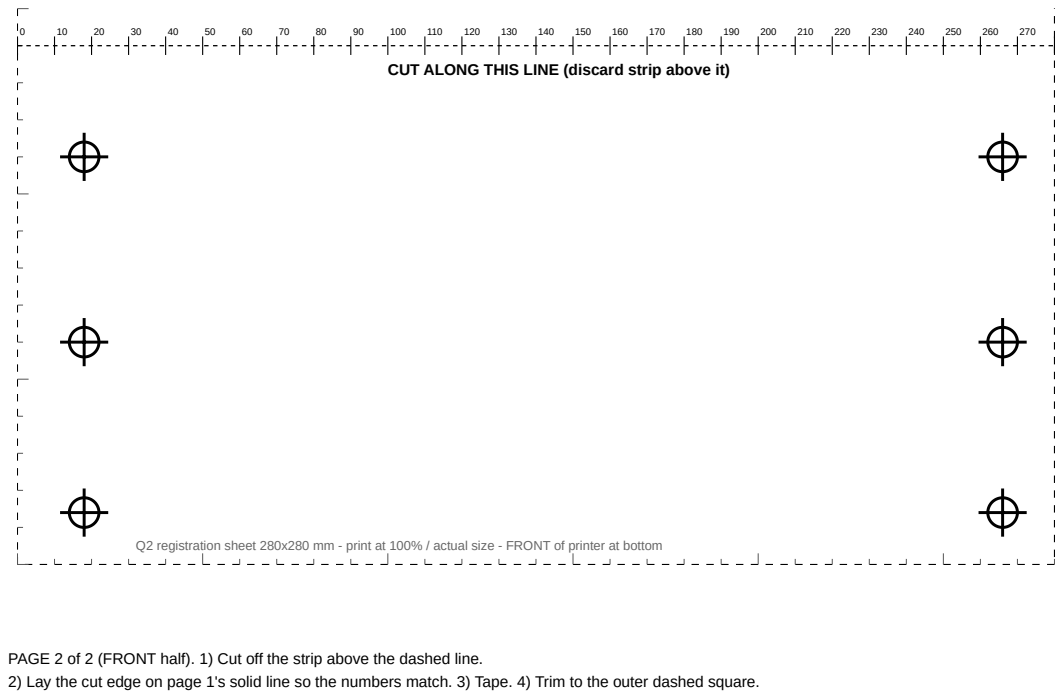
[picture p44: page 2]

CUT ALONG THIS LINE (discard strip above it)

Q2 registration sheet 280x280 mm - print at 100% / actual size - FRONT of printer at bottom

PAGE 2 of 2 (FRONT half). 1) Cut off the strip above the dashed line.
2) Lay the cut edge on page 1's solid line so the numbers match. 3) Tape. 4) Trim to the outer dashed square.
