rayaanatif/qidi-q2-pen-plotter/hardware/registration-plate/q2_regsheet_A3.pdf

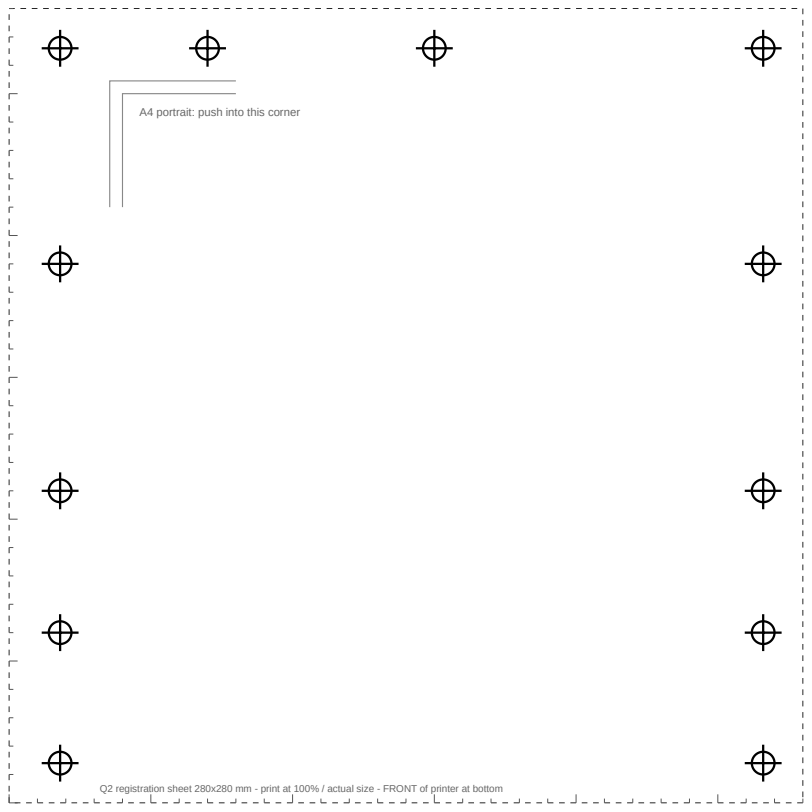
[picture p45: page 1]

A4 portrait: push into this corner

Q2 registration sheet 280x280 mm - print at 100% / actual size - FRONT of printer at bottom
