rayaanatif/qidi-q2-pen-plotter/app-pro/printables/alignment_sheet_A4.pdf

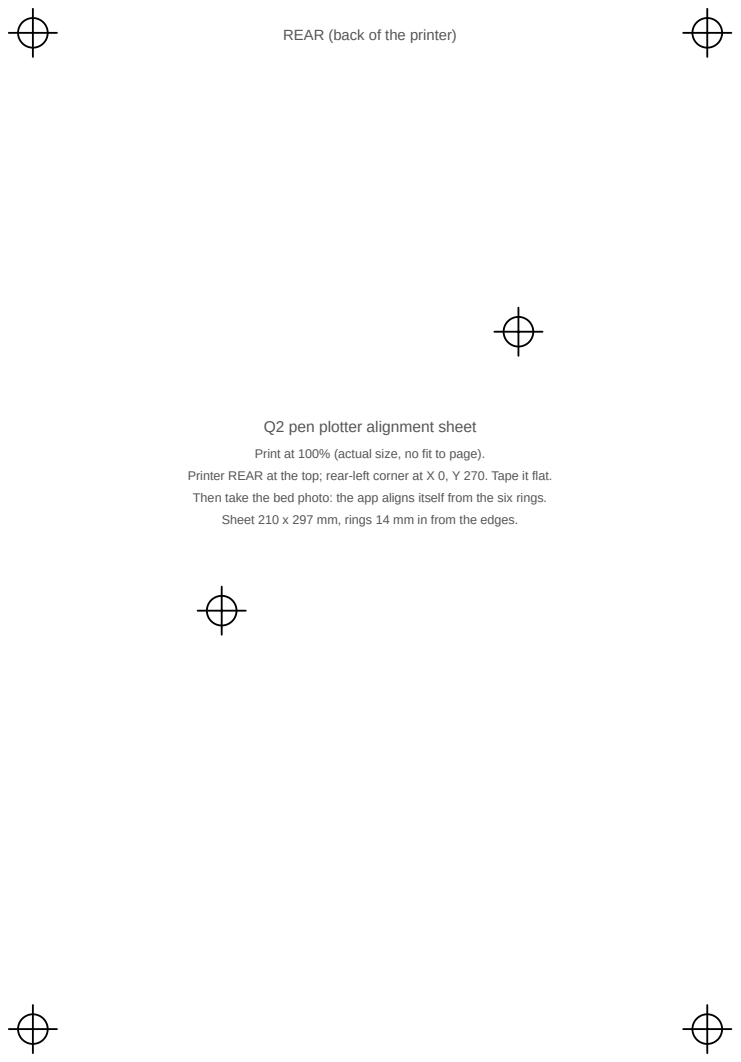
[picture p46: page 1]

REAR (back of the printer)

Q2 pen plotter alignment sheet

Print at 100% (actual size, no fit to page).

Printer REAR at the top; rear-left corner at X 0, Y 270. Tape it flat.
Then take the bed photo: the app aligns itself from the six rings.
Sheet 210 x 297 mm, rings 14 mm in from the edges.
