rayaanatif/qidi-q2-pen-plotter/(commit log)

2026-11-06 Initial release: pen plotter app, plotter.cfg, mount files, setup docs
    [plotter.cfg, qs_cover_v4_A_FRONT_DOWN_print.step, qs_cover_v4_A_FRONT_DOWN_print.stl, qs_cover_v4_A_model_orientation.step, qs_cover_v4_B_FRONT_DOWN_print.step, qs_cover_v4_B_FRONT_DOWN_print.stl, qs_cover_v4_B_model_orientation.step, qs_cutter_sleeve_v1_bore10.5.stl]
2026-11-07 Add pen height jig and use it in the setup guide
    [qs_pen_height_jig_v1_tip3.2.stl, qs_pen_height_jig_v1_tip4.2.stl, qs_pen_height_jig_v1_tip5.2.stl]
2026-11-07 Add experimental screwless wedge clip for the bay
    [qs_bay_wedge_clip_v1_end7.7.stl, qs_bay_wedge_clip_v1_end7.9.stl, qs_bay_wedge_clip_v1_end8.1.stl]
2026-11-07 Add pen cartridges from 7.0 to 11.5 mm bore
    [qs_pen_cartridge_v4_bore10.5.stl, qs_pen_cartridge_v4_bore11.0.stl, qs_pen_cartridge_v4_bore11.5.stl, qs_pen_cartridge_v4_bore7.0.stl, qs_pen_cartridge_v4_bore7.5.stl, qs_pen_cartridge_v4_bore8.0.stl, qs_pen_cartridge_v4_bore8.5.stl]
2026-11-07 Add looser dovetail bay variants (0.30, 0.40)
    [qs_pen_bay_v4_looser_dovetail_0.30.stl, qs_pen_bay_v4_looser_dovetail_0.40.stl]
2026-11-07 Add looser-dovetail, shorter-top cover A variants
    [qs_cover_v4_A_dovetail_looser_2.10_top-1.8_print.stl, qs_cover_v4_A_dovetail_looser_2.20_top-1.8_print.stl, qs_pen_bay_v4_looser_dovetail_0.30.stl, qs_pen_bay_v4_looser_dovetail_0.40.stl]
2026-11-07 Add STEP files for looser-dovetail, shorter-top cover A
    [qs_cover_v4_A_dovetail_looser_2.10_top-1.8_FRONT_DOWN_print.step, qs_cover_v4_A_dovetail_looser_2.10_top-1.8_model_orientation.step, qs_cover_v4_A_dovetail_looser_2.20_top-1.8_FRONT_DOWN_print.step, qs_cover_v4_A_dovetail_looser_2.20_top-1.8_model_orientation.step]
2026-11-07 Close roof pin holes at the top; STEP-only looser cover
    [qs_cover_v4_A_dovetail_looser_2.10_top-1.8_FRONT_DOWN_print.step, qs_cover_v4_A_dovetail_looser_2.10_top-1.8_model_orientation.step, qs_cover_v4_A_dovetail_looser_2.10_top-1.8_print.stl, qs_cover_v4_A_dovetail_looser_2.20_top-1.8_FRONT_DOWN_print.step, qs_cover_v4_A_dovetail_looser_2.20_top-1.8_model_orientation.step, qs_cover_v4_A_dovetail_looser_2.20_top-1.8_print.stl]
2026-11-07 Add stiffer pen bay v5 (side wings, optional comb tines)
    [qs_pen_bay_v5_stiff_flanges_comb_print.stl, qs_pen_bay_v5_stiff_flanges_print.stl]
2026-11-07 Pen bay v5 as STEP (replaces STL), teardrop tips up
    [qs_pen_bay_v5_stiff_flanges_comb_model_orientation.step, qs_pen_bay_v5_stiff_flanges_comb_print.step, qs_pen_bay_v5_stiff_flanges_comb_print.stl, qs_pen_bay_v5_stiff_flanges_model_orientation.step, qs_pen_bay_v5_stiff_flanges_print.step, qs_pen_bay_v5_stiff_flanges_print.stl]
2026-11-07 Pen bay v6: barrel top as a 45 degree ramp (no supports)
    [qs_pen_bay_v5_stiff_flanges_comb_model_orientation.step, qs_pen_bay_v5_stiff_flanges_comb_print.step, qs_pen_bay_v5_stiff_flanges_model_orientation.step, qs_pen_bay_v5_stiff_flanges_print.step, qs_pen_bay_v6_ramp_flanges_comb_model_orientation.step, qs_pen_bay_v6_ramp_flanges_comb_print.step, qs_pen_bay_v6_ramp_flanges_model_orientation.step, qs_pen_bay_v6_ramp_flanges_print.step]
2026-11-09 Add STEP files for 9.0 and 10.0 mm pen cartridges
    [qs_pen_cartridge_v4_bore10.0.step, qs_pen_cartridge_v4_bore9.0.step]
2026-11-09 App: auto-fit sheet from a phone photo (plate corners, any sheet position and angle)
2026-11-09 Auto-fit: start from a centred box when the plate guess is not plate-shaped
2026-11-09 Auto-fit: texture-based plate detection and sheet detection that ignores plate glare
2026-11-09 Auto-fit: sheet fitted from its straight edges (tolerates toolhead/rail), ranked plate guesses, remembers last corners
2026-11-09 Aligner: zoomed corner tapping with overview inset; block areas off the plate
2026-11-09 Auto-fit: say 'no sheet found' instead of guessing when nothing stands out from the plate
2026-11-09 Bed photo: remove automatic sheet detection; align to plate corners or sheet corners
2026-11-09 Bed photo: measure mode (distances, angles, area between tapped points)
2026-11-09 app-pro: Prepare / Preview / Device / Settings workspace, printer status bar, G-code console
2026-11-09 app-pro: image to SVG drawing styles (hatch, squiggle, stipple, flow, spiral, halftone), colour pen separation, physical output size
2026-11-09 app-pro: printable alignment sheet (button + A4 PDF)
2026-11-09 Add magnetic registration plate (STEP/STL, layout)
    [q2_regplate.step, q2_regplate_black_marks.stl, q2_regplate_combined.stl, q2_regplate_white_base.stl]
2026-11-09 Add printable full-plate registration sheet (A3 and 2xA4)
2026-11-09 Registration sheet: 280 mm plate
2026-11-09 Registration sheet: cut-and-align seam for 2xA4
2026-11-09 Park at default purge/trash position (X85 Y287.5)
    [plotter.cfg]
2026-11-09 app-pro: Park toolhead for photo button
2026-11-09 Add 280 mm plate replica in 4 printable tiles; drop the 264 mm plate
    [q2_plate280_tile_LF.step, q2_plate280_tile_LF.stl, q2_plate280_tile_LR.step, q2_plate280_tile_LR.stl, q2_plate280_tile_RF.step, q2_plate280_tile_RF.stl, q2_plate280_tile_RR.step, q2_plate280_tile_RR.stl]
2026-11-09 Tiles: raised black rings + paper stop for dual colour, light base colour
    [q2_plate280_tile_LF.step, q2_plate280_tile_LF.stl, q2_plate280_tile_LF_base.stl, q2_plate280_tile_LF_black.stl, q2_plate280_tile_LF_combined.stl, q2_plate280_tile_LR.step, q2_plate280_tile_LR.stl, q2_plate280_tile_LR_base.stl]
2026-11-09 Tiles: remove paper corner stop
    [q2_plate280_tile_LR.step, q2_plate280_tile_LR_black.stl, q2_plate280_tile_LR_combined.stl]
2026-11-11 app-pro: mat edges fitted with RANSAC so a toolhead or paper over an edge no longer pulls the corner inward
2026-11-11 app-pro: mat registration uses every visible grid line (not only crossings) and centres the plate between the mat edges
2026-11-11 app-pro: remove the A4 sheet outline and label from the bed view
2026-11-11 Paper mode: margin only in paper mode, usable area always limited to the plate
2026-11-11 PLOT_START: stay at park height and leave the purge bin before the first Z drop
    [plotter.cfg]
2026-11-11 PLOT_START: leave the park spot in Y only (clear_y) before any X move
    [plotter.cfg]
2026-11-11 PLOT_MESH and PEN_TOUCH: leave the purge park spot (Y only) and go to bed centre first
    [plotter.cfg]
2026-11-11 Mat detection: take the direction of a mostly hidden edge from the opposite edge (magnet on the corner)
2026-11-13 Add floating cutter cartridge (single printed part with coil spring), untested
    [qs_cutter_float_v1_3turn_bore11.3.stl, qs_cutter_float_v1_4turn_bore11.3.stl]
2026-11-13 Add GCC-holder cutter bay and printed-coil pusher module (untested), update cutter docs
    [qs_cutter_bay_v1.stl, qs_cutter_pusher_v1_firm.stl, qs_cutter_pusher_v1_soft.stl, qs_cutter_pusher_v1_std.stl]
2026-11-13 Add hard pusher variant (cut force above 165 gf at 4 mm blade)
    [qs_cutter_pusher_v1_hard.stl]
2026-11-13 Cutter v2: thumbwheel force adjuster, key-bar retention, replaces v1 detent
    [qs_cutter_adj_frame_v2.stl, qs_cutter_adj_plunger_v2.stl, qs_cutter_adj_rod_knob_v2.stl, qs_cutter_bay_v1.stl, qs_cutter_bay_v2.stl, qs_cutter_key_v2.stl, qs_cutter_pusher_v1_firm.stl, qs_cutter_pusher_v1_hard.stl]
2026-11-13 Cover: add lift stop pad under the toolhead block so upward cutting force cannot pull the cover off
    [qs_cover_v5_A_dovetail_looser_2.10_top-1.8_liftstop_FRONT_DOWN_print.step, qs_cover_v5_A_dovetail_looser_2.10_top-1.8_liftstop_FRONT_DOWN_print.stl, qs_cover_v5_A_dovetail_looser_2.10_top-1.8_liftstop_model_orientation.step, qs_cover_v5_A_dovetail_looser_2.20_top-1.8_liftstop_FRONT_DOWN_print.step, qs_cover_v5_A_dovetail_looser_2.20_top-1.8_liftstop_FRONT_DOWN_print.stl, qs_cover_v5_A_dovetail_lo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]
2026-11-13 Cover lift stop: wider pad, 0.15 and 0.40 mm gap variants
    [qs_cover_v5_A_dovetail_looser_2.10_top-1.8_liftstop_FRONT_DOWN_print.step, qs_cover_v5_A_dovetail_looser_2.10_top-1.8_liftstop_FRONT_DOWN_print.stl, qs_cover_v5_A_dovetail_looser_2.10_top-1.8_liftstop_gap0.15_FRONT_DOWN_print.step, qs_cover_v5_A_dovetail_looser_2.10_top-1.8_liftstop_gap0.15_FRONT_DOWN_print.stl, qs_cover_v5_A_dovetail_looser_2.10_top-1.8_liftstop_gap0.15_model_orientation.step, q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]
2026-11-13 Cover block stop: rib and hook tongue under the black block (replaces low lift pad)
    [qs_cover_v5_A_dovetail_looser_2.10_top-1.8_liftstop_gap0.15_FRONT_DOWN_print.step, qs_cover_v5_A_dovetail_looser_2.10_top-1.8_liftstop_gap0.15_FRONT_DOWN_print.stl, qs_cover_v5_A_dovetail_looser_2.10_top-1.8_liftstop_gap0.15_model_orientation.step, qs_cover_v5_A_dovetail_looser_2.10_top-1.8_liftstop_gap0.40_FRONT_DOWN_print.step, qs_cover_v5_A_dovetail_looser_2.10_top-1.8_liftstop_gap0.40_FRONT_D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]
2026-11-13 Cutter v3: true parametric STEP (arcs, helical springs/threads), print-orientation STEP+STL, fit checks
    [qs_cutter_adj_frame_v3_model_orientation.step, qs_cutter_adj_frame_v3_print.step, qs_cutter_adj_frame_v3_print.stl, qs_cutter_adj_plunger_v3_model_orientation.step, qs_cutter_adj_plunger_v3_print.step, qs_cutter_adj_plunger_v3_print.stl, qs_cutter_adj_rod_knob_v3_model_orientation.step, qs_cutter_adj_rod_knob_v3_print.step]
